teedeeus/Easy8085/Easy8085.kicad_pcb

## KiCad design Easy8085.kicad_pcb (2022-02-14)

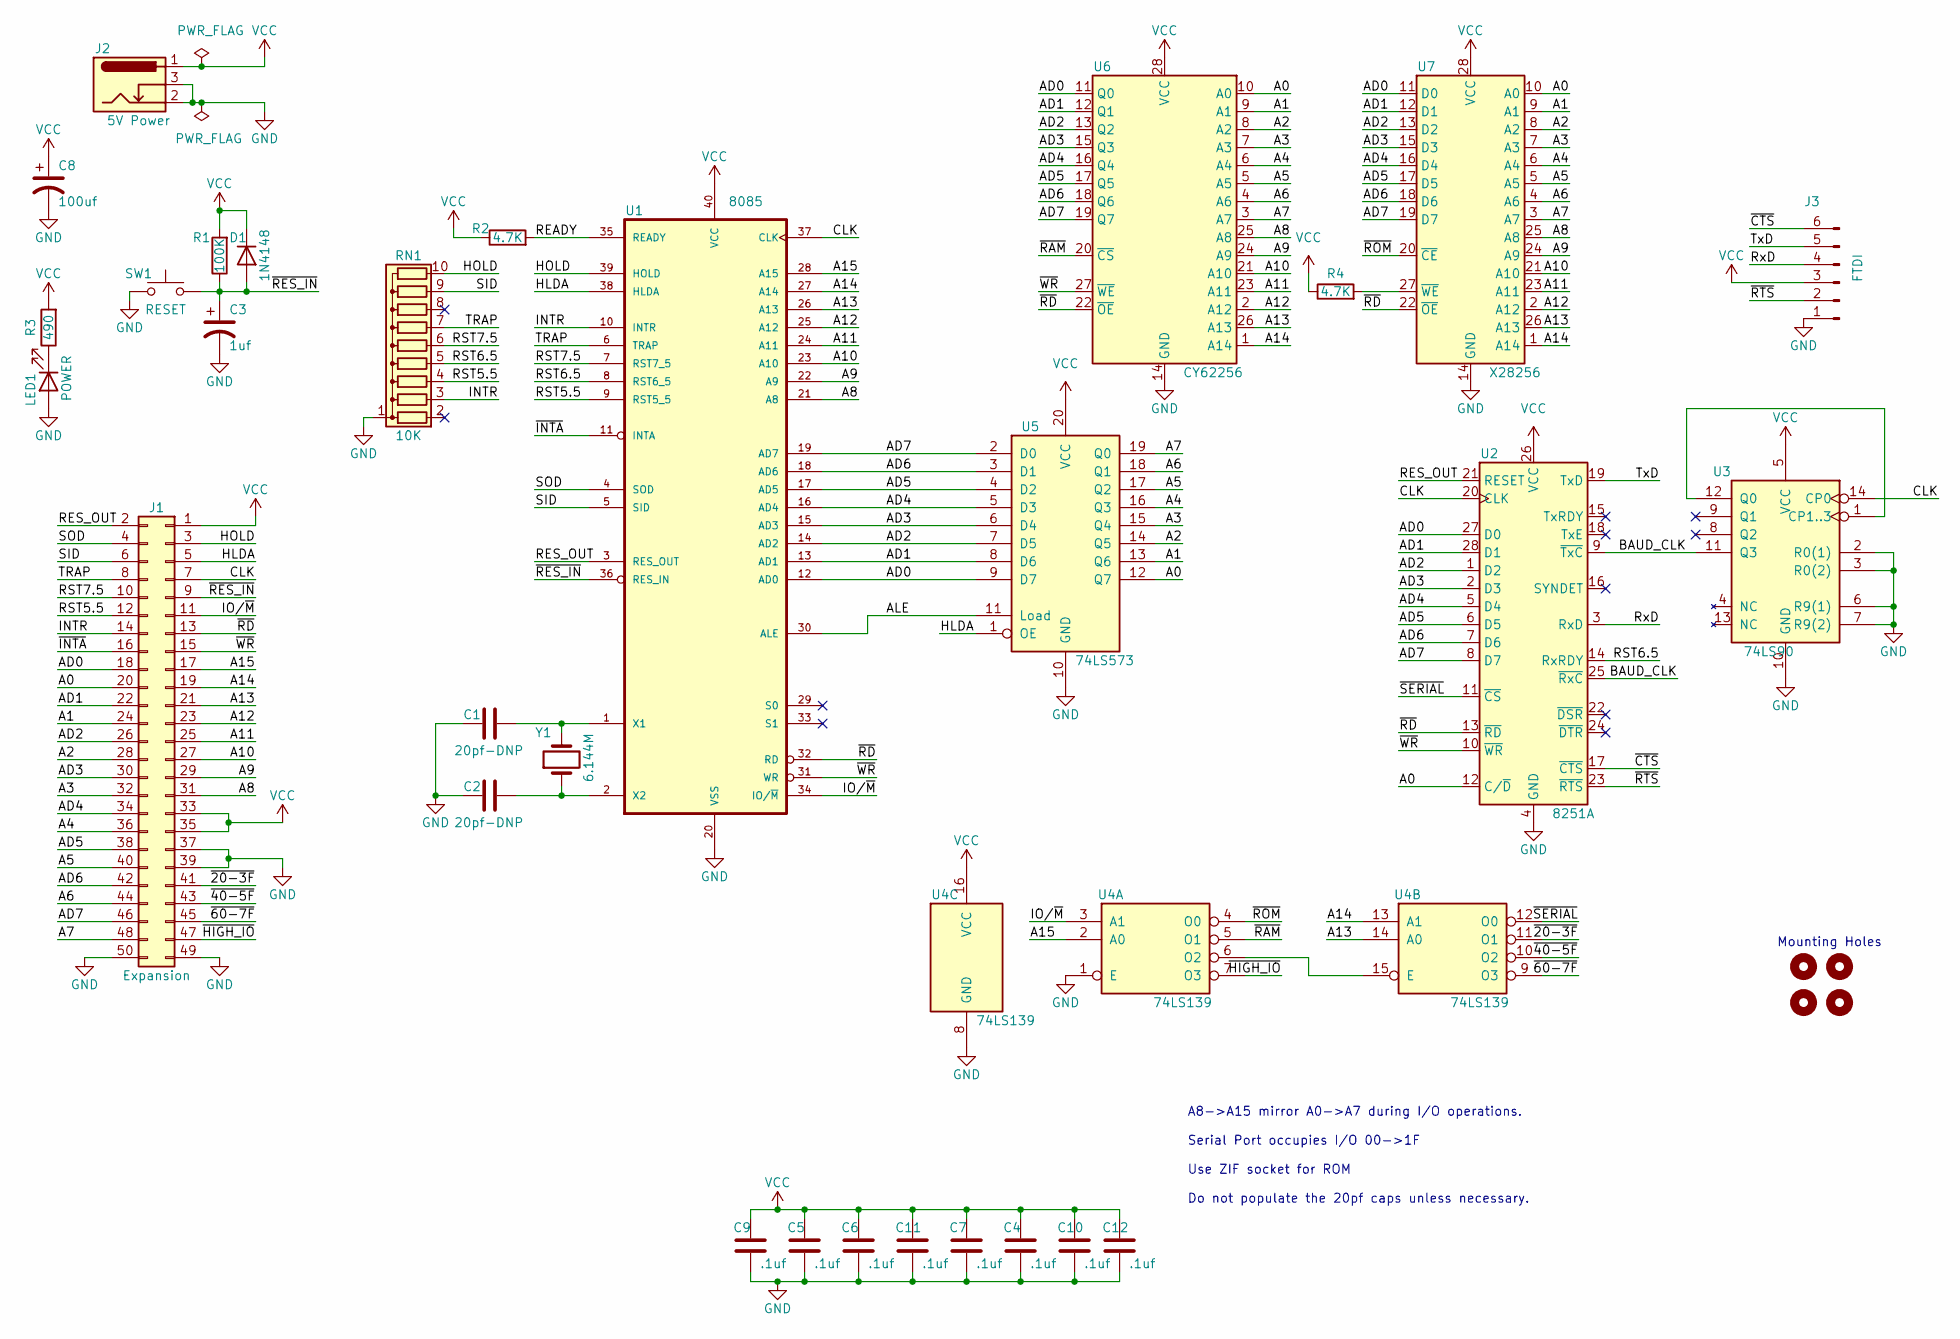
[picture p1: schematic Easy8085.kicad_sch]

Parts:
C1, C2: 20pf-DNP; C_Disc_D3.4mm_W2.1mm_P2.50mm
C3: 1uf; CP_Radial_D7.5mm_P2.50mm
C4, C5, C6, C7, C9, C10, C11, C12: .1uf; C_Disc_D3.4mm_W2.1mm_P2.50mm
C8: 100uf; CP_Radial_D7.5mm_P2.50mm
D1: 1N4148; D_DO-35_SOD27_P7.62mm_Horizontal
H1, H2, H3, H4: MountingHole; MountingHole_2.7mm_M2.5
J1: Expansion; PinHeader_2x25_P2.54mm_Vertical
J2: 5V Power; BarrelJack_GCT_DCJ200-10-A_Horizontal
J3: FTDI; PinSocket_1x06_P2.54mm_Horizontal
LED1: POWER; LED_D5.0mm
R1: 100K; R_Axial_DIN0204_L3.6mm_D1.6mm_P7.62mm_Horizontal
R2, R4: 4.7K; R_Axial_DIN0204_L3.6mm_D1.6mm_P7.62mm_Horizontal
R3: 490; R_Axial_DIN0204_L3.6mm_D1.6mm_P7.62mm_Horizontal
RN1: 10K; R_Array_SIP10
SW1: RESET; SW_PUSH_6mm_H5mm
U1: 8085; DIP-40_W15.24mm_Socket
U2: 8251A; DIP-28_W15.24mm_Socket
U3: 74LS90; DIP-14_W7.62mm_Socket
U4: 74LS139; DIP-16_W7.62mm_Socket
U5: 74LS573; DIP-20_W7.62mm_Socket
U6: CY62256; DIP-28_W15.24mm_Socket
U7: X28256; DIP_Socket-28_W11.9_W12.7_W15.24_W17.78_W18.5_3M_228-1277-0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
Y1: 6.144M; Crystal_HC49-4H_Vertical

Connections:
/A0: J1.20, U2.12 (C/~D), U5.12 (Q7), U6.10 (A0), U7.10 (A0)
/A1: J1.24, U5.13 (Q6), U6.9 (A1), U7.9 (A1)
/A2: J1.28, U5.14 (Q5), U6.8 (A2), U7.8 (A2)
/A3: J1.32, U5.15 (Q4), U6.7 (A3), U7.7 (A3)
/A4: J1.36, U5.16 (Q3), U6.6 (A4), U7.6 (A4)
/A5: J1.40, U5.17 (Q2), U6.5 (A5), U7.5 (A5)
/A6: J1.44, U5.18 (Q1), U6.4 (A6), U7.4 (A6)
/A7: J1.48, U5.19 (Q0), U6.3 (A7), U7.3 (A7)
/A8: J1.31, U1.21 (A8), U6.25 (A8), U7.25 (A8)
/A9: J1.29, U1.22 (A9), U6.24 (A9), U7.24 (A9)
/A10: J1.27, U1.23 (A10), U6.21 (A10), U7.21 (A10)
/A11: J1.25, U1.24 (A11), U6.23 (A11), U7.23 (A11)
/A12: J1.23, U1.25 (A12), U6.2 (A12), U7.2 (A12)
/A13: J1.21, U1.26 (A13), U4.14 (A0), U6.26 (A13), U7.26 (A13)
/A14: J1.19, U1.27 (A14), U4.13 (A1), U6.1 (A14), U7.1 (A14)
/A15: J1.17, U1.28 (A15), U4.2 (A0)
/AD0: J1.18, U1.12 (AD0), U2.27 (D0), U5.9 (D7), U6.11 (Q0), U7.11 (D0)
/AD1: J1.22, U1.13 (AD1), U2.28 (D1), U5.8 (D6), U6.12 (Q1), U7.12 (D1)
/AD2: J1.26, U1.14 (AD2), U2.1 (D2), U5.7 (D5), U6.13 (Q2), U7.13 (D2)
/AD3: J1.30, U1.15 (AD3), U2.2 (D3), U5.6 (D4), U6.15 (Q3), U7.15 (D3)
/AD4: J1.34, U1.16 (AD4), U2.5 (D4), U5.5 (D3), U6.16 (Q4), U7.16 (D4)
/AD5: J1.38, U1.17 (AD5), U2.6 (D5), U5.4 (D2), U6.17 (Q5), U7.17 (D5)
/AD6: J1.42, U1.18 (AD6), U2.7 (D6), U5.3 (D1), U6.18 (Q6), U7.18 (D6)
/AD7: J1.46, U1.19 (AD7), U2.8 (D7), U5.2 (D0), U6.19 (Q7), U7.19 (D7)
/ALE: U1.30 (ALE), U5.11 (Load)
/BAUD_CLK: U2.9 (~TxC), U2.25 (~RxC), U3.11 (Q3)
/CLK: J1.7, U1.37 (CLK), U2.20 (CLK), U3.14 (CP0)
/HLDA: J1.5, U1.38 (HLDA), U5.1 (OE)
/HOLD: J1.3, RN1.10 (R9), U1.39 (HOLD)
/INTR: J1.14, RN1.3 (R2), U1.10 (INTR)
/IO/~M: J1.11, U1.34 (IO/~M), U4.3 (A1)
/READY: R2.2, U1.35 (READY)
/RES_OUT: J1.2, U1.3 (RES_OUT), U2.21 (RESET)
/RST5.5: J1.12, RN1.4 (R3), U1.9 (RST5_5)
/RST6.5: RN1.5 (R4), U1.8 (RST6_5), U2.14 (RxRDY)
/RST7.5: J1.10, RN1.6 (R5), U1.7 (RST7_5)
/RxD: J3.4, U2.3 (RxD)
/SID: J1.6, RN1.9 (R8), U1.5 (SID)
/SOD: J1.4, U1.4 (SOD)
/TRAP: J1.8, RN1.7 (R6), U1.6 (TRAP)
/TxD: J3.5, U2.19 (TxD)
/~20-3F: J1.41, U4.11 (O1)
/~40-5F: J1.43, U4.10 (O2)
/~60-7F: J1.45, U4.9 (O3)
/~CTS: J3.6, U2.17 (~CTS)
/~HIGH_IO: J1.47, U4.7 (O3)
/~INTA: J1.16, U1.11 (INTA)
/~RAM: U4.5 (O1), U6.20 (~CS)
/~RD: J1.13, U1.32 (RD), U2.13 (~RD), U6.22 (~OE), U7.22 (~OE)
/~RES_IN: C3.1, D1.2 (A), J1.9, R1.1, SW1.2, U1.36 (RES_IN)
/~ROM: U4.4 (O0), U7.20 (~CE)
/~RTS: J3.2, U2.23 (~RTS)
/~SERIAL: U2.11 (~CS), U4.12 (O0)
/~WR: J1.15, U1.31 (WR), U2.10 (~WR), U6.27 (~WE)
GND: C1.2, C2.2, C3.2, C4.2, C5.2, C6.2, C7.2, C8.2, C9.2, C10.2, C11.2, C12.2, J1.37, J1.39, J1.49, J1.50, J2.2, J2.3, J3.1, LED1.2 (A), RN1.1 (common), SW1.1, U1.20 (VSS), U2.4 (GND), U3.2 (R0(1)), U3.3 (R0(2)), U3.6 (R9(1)), U3.7 (R9(2)), U3.10 (GND), U4.1 (E), U4.8 (GND), U5.10 (GND), U6.14 (GND), U7.14 (GND)
unnamed: C1.1, U1.1 (X1), Y1.2
unnamed: C2.1, U1.2 (X2), Y1.1
unnamed: LED1.1 (K), R3.1
unnamed: R4.2, U7.27 (~WE)
unnamed: U3.1 (CP1..3), U3.12 (Q0)
unnamed: U4.6 (O2), U4.15 (E)
VCC: C4.1, C5.1, C6.1, C7.1, C8.1, C9.1, C10.1, C11.1, C12.1, D1.1 (K), J1.1, J1.33, J1.35, J2.1, J3.3, R1.2, R2.1, R3.2, R4.1, U1.40 (VCC), U2.26 (VCC), U3.5 (VCC), U4.16 (VCC), U5.20 (VCC), U6.28 (VCC), U7.28 (VCC)

Notes on the sheet:
A8->A15 mirror A0->A7 during I/O operations. Serial Port occupies I/O 00->1F Use ZIF socket for ROM Do not populate the 20pf caps unless necessary.
Mounting Holes

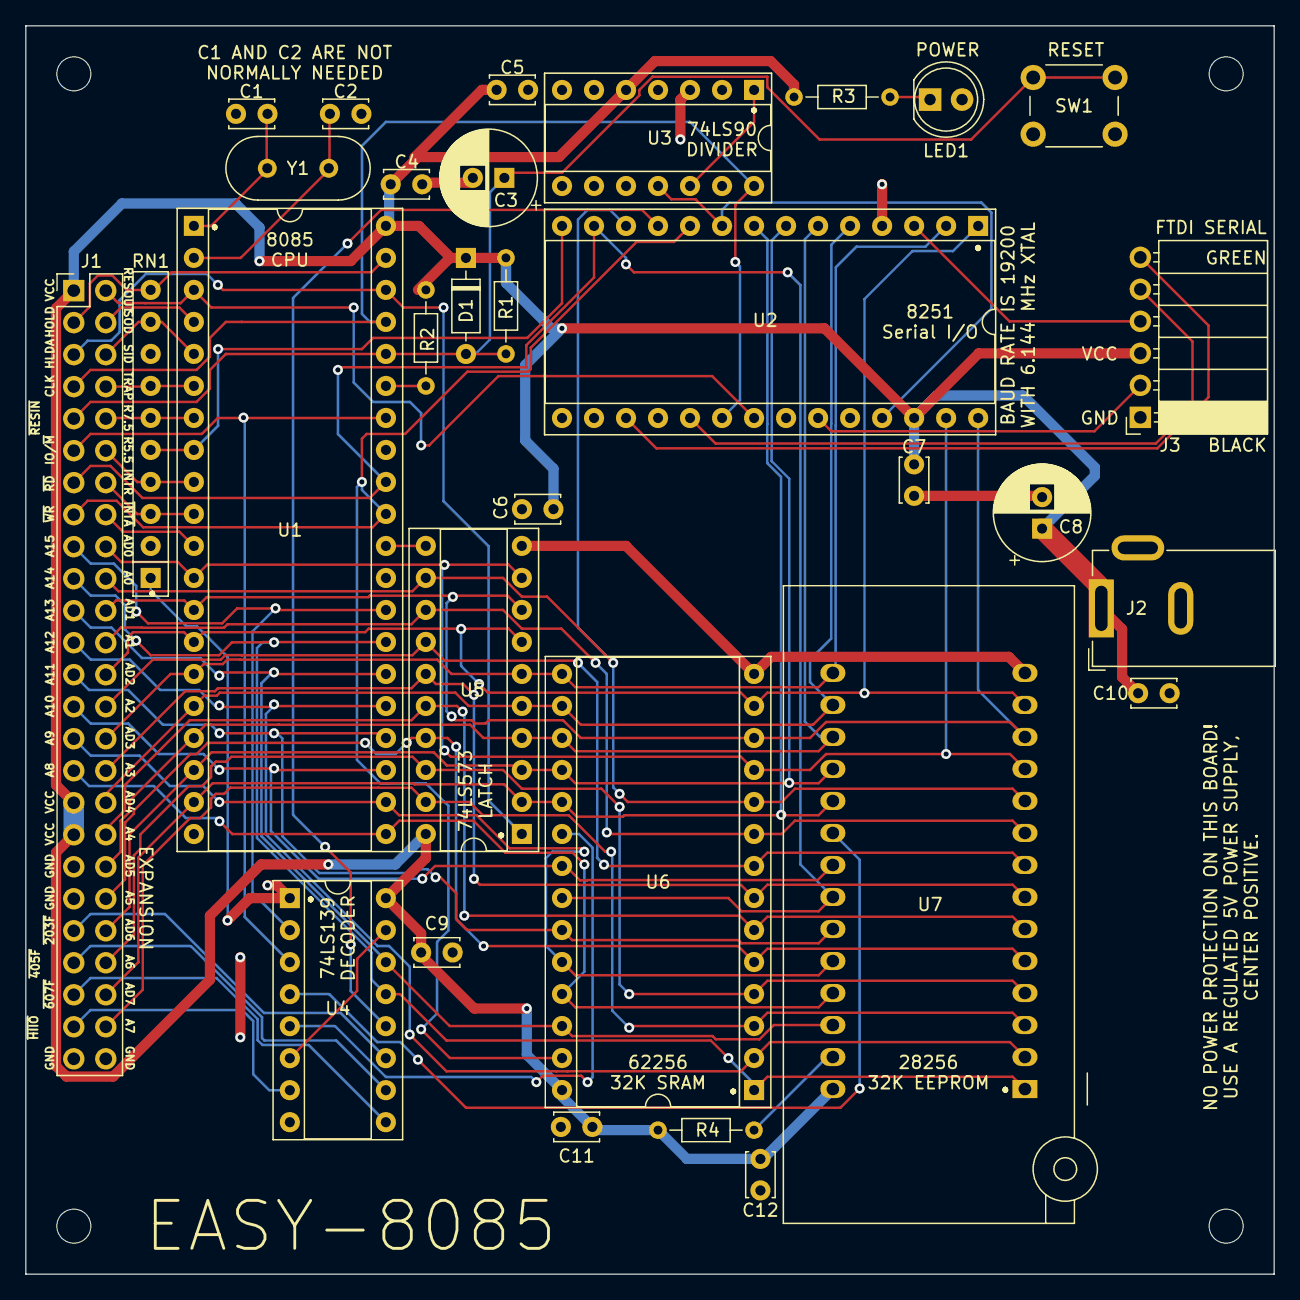
[picture p2: board Easy8085.kicad_pcb from above]

Board: 2 copper layers, 99.1 x 99.1 mm, 35 parts (0 on the bottom side), 62 nets.
