teedeeus/Easy8085/(commit log)

2022-02-08 re-working PCB and schematic to seperate expansion connector and reduce parts.
    [Easy8085.kicad_pcb, Easy8085.kicad_sch]
2022-02-08 Continuing PCB layout.
    [Easy8085.kicad_pcb, Easy8085.kicad_sch]
2022-02-08 Still working on layout - what a pain.
    [Easy8085.kicad_pcb]
2022-02-08 Changing to 4 layer board.
    [Easy8085.kicad_pcb]
2022-02-09 4 layer board continued...
    [Easy8085.kicad_pcb, Easy8085.kicad_sch]
2022-02-10 Finally making progress on the layout.
    [Easy8085.kicad_pcb, Easy8085.kicad_sch]
2022-02-10 Finish routing the board
    [Easy8085.kicad_pcb]
2022-02-10 Added kicad .gitignore.
2022-02-10 Finished board routing. Need to fix silkscreen
    [Easy8085.kicad_pcb, Easy8085.kicad_sch]
2022-02-11 Fixed errors in PCB layout
    [Easy8085.kicad_pcb, Easy8085.kicad_sch]
2022-02-11 Fixed mounting holes and re-annotated schematic
    [Easy8085.kicad_pcb, Easy8085.kicad_sch]
2022-02-11 Finished layout
    [Easy8085.kicad_pcb, Easy8085.kicad_sch]
2022-02-13 Finished layout, produced gerbers for JLC-PCB
    [Easy8085-B_Cu.gbl, Easy8085-B_Mask.gbs, Easy8085-B_Paste.gbp, Easy8085-B_Silkscreen.gbo, Easy8085-Edge_Cuts.gm1, Easy8085-F_Cu.gtl, Easy8085-F_Mask.gts, Easy8085-F_Paste.gtp]
2022-02-14 Found and fixed error with AD0-7 reversed on UART
    [Easy8085-B_Cu.gbl, Easy8085-B_Mask.gbs, Easy8085-B_Paste.gbp, Easy8085-B_Silkscreen.gbo, Easy8085-Edge_Cuts.gm1, Easy8085-F_Cu.gtl, Easy8085-F_Mask.gts, Easy8085-F_Paste.gtp]
